bondians/led-thing/hardware/power-board/power-board.xlsx

 |  |  |  |  |  |  |  | Board Qty: | 5
 |  |  |  |  |  |  |  | Total Cost: | $266.84 |  |  |  | $273.83 |  |  |  |  |  | $179.22
 |  |  |  |  |  |  |  | Unit Cost: | $53.37
Global Part Info |  |  |  |  |  |  |  |  |  | Digi-Key |  |  |  |  |  | Mouser
Refs | Value | Desc | Note | Footprint | Manf | Manf# | Qty | Unit$ | Ext$ | Avail | Purch | Unit$ | Ext$ | Cat# | Doc | Avail | Purch | Unit$ | Ext$ | Cat# | Doc
J1001 | PA[5..7] |  |  | Pin_Headers:Pin_Header_Straight_1x03_Pitch2.54mm |  |  | 5 | $0.00 | $0.00
R303 | 105k |  |  | Resistors_SMD:R_0805 | Yageo | RC0805FR-07105KL | 5 | $0.10 | $0.50 | 150558 |  | $0.10 | $0.50 | 311-105KCRCT-ND | Link (http://www.digikey.com/product-detail/en/yageo/RC0805FR-07105KL/311-105KCRCT-ND/730495) | 15239 |  | $0.10 | $0.50 | 603-RC0805FR-07105KL | Link (http://www.mouser.com/ProductDetail/Yageo/RC0805FR-07105KL/?qs=sGAEpiMZZMu61qfTUdNhG92fxgWN7axftU0W8jCwEoE%3d)
E301 | SPARK_GAP |  |  | project:Spark_Gap_8mil |  |  | 5 | $0.00 | $0.00
U401 | TLV521 |  |  | TO_SOT_Packages_SMD:SOT-353_SC-70-5 | Texas Instruments | TLV521DCKR | 5 | $0.18 | $0.92 |  |  | $0.18 | $0.92 | TLV521DCKR-ND | Link (http://www.digikey.com/scripts/DkSearch/dksus.dll?WT.z_header=search_go&lang=en&keywords=TLV521DCKR) | 56085 |  | $0.51 | $2.56 | 595-TLV521DCKR | Link (http://www.mouser.com/ProductDetail/Texas-Instruments/TLV521DCKR/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)
U1101 | TPD2E001IDRLRQ1 |  |  | TO_SOT_Packages_SMD:SOT-553 | Texas Instruments | TPD2E001IDRLRQ1 | 5 | $0.57 | $2.86 | 4979 |  | $0.58 | $2.90 | 296-29985-1-ND | Link (http://www.digikey.com/product-detail/en/texas-instruments/TPD2E001IDRLRQ1/296-29985-1-ND/2791193) | 9891 |  | $0.57 | $2.86 | 595-TPD2E001IDRLRQ1 | Link (http://www.mouser.com/Search/Refine.aspx?Keyword=TPD2E001IDRLRQ1)
D301 | 5A |  |  | Diodes_SMD:D_SMC_Standard | SMC Diode Solutions | SK520TR | 5 | $0.42 | $2.10 | 1160 |  | $0.42 | $2.10 | 1655-1603-1-ND | Link (http://www.digikey.com/product-detail/en/smc-diode-solutions/SK520TR/1655-1603-1-ND/6023048)
R401 | 10M |  | 1% | Resistors_SMD:R_0805 | Yageo | RC0805FR-0710ML | 5 | $0.10 | $0.50 | 309331 |  | $0.10 | $0.50 | 311-10.0MCRCT-ND | Link (http://www.digikey.com/product-detail/en/yageo/RC0805FR-0710ML/311-10.0MCRCT-ND/730483)
C501 | 10n |  | DNS | Capacitors_SMD:C_0603 | Murata Electronics | GRM188R71H103JA01D | 5 | $0.10 | $0.50 | 86478 |  | $0.10 | $0.50 | 490-9734-1-ND | Link (http://www.digikey.com/product-detail/en/murata-electronics-north-america/GRM188R71H103JA01D/490-9734-1-ND/4934907)
J1002 | PB[0..3] |  |  | Pin_Headers:Pin_Header_Straight_1x04_Pitch2.54mm |  |  | 5 | $0.00 | $0.00
J801 | CONN_02X05 |  |  | Connectors:IDC_Header_Straight_10pins | 3M Electronic Solutions Division | N2510-6002RB | 5 | $1.48 | $7.40 | 13958 |  | $1.84 | $9.20 | MHC10K-ND | Link (http://www.digikey.com/product-detail/en/3m/N2510-6002-RB/MHC10K-ND/755176) | 13226 |  | $1.48 | $7.40 | 517-N2510-6002RB | Link (http://www.mouser.com/ProductDetail/3M-Electronic-Solutions-Division/N2510-6002RB/)
U701 | Main Reg |  |  | Housings_SSOP:MSOP-8_3x3mm_Pitch0.65mm | Microchip Technology | AT30TS74-XM8M-B | 5 | $0.56 | $2.80 | 2539 |  | $0.56 | $2.80 | 1611-AT30TS74-XM8M-B-ND | Link (http://www.digikey.com/product-detail/en/microchip-technology/AT30TS74-XM8M-B/1611-AT30TS74-XM8M-B-ND/6829296)
J301 | CONN_01X02 |  |  | Connectors_Terminal_Blocks:TerminalBlock_Pheonix_PT-3.5mm_2pol | Phoenix Contact | 1984617 | 5 | $0.43 | $2.15 | 15649 |  | $0.43 | $2.15 | 277-1721-ND | Link (http://www.digikey.com/scripts/DkSearch/dksus.dll?WT.z_header=search_go&lang=en&keywords=1984617) | 7214 |  | $0.43 | $2.16 | 651-1984617 | Link (http://www.mouser.com/Search/Refine.aspx?Keyword=1984617)
C212 | 0.47u |  |  | Capacitors_SMD:C_0603 | Murata Electronics | GCM188R71C474KA55D | 5 | $0.13 | $0.65 | 141742 |  | $0.13 | $0.65 | 490-4775-1-ND | Link (http://www.digikey.com/product-detail/en/murata-electronics-north-america/GCM188R71C474KA55D/490-4775-1-ND/1641694)
R304 | 4.02k |  |  | Resistors_SMD:R_0805 | Yageo | RC0805FR-074K02L | 5 | $0.10 | $0.50 | 174315 |  | $0.10 | $0.50 | 311-4.02KCRCT-ND | Link (http://www.digikey.com/product-detail/en/yageo/RC0805FR-074K02L/311-4.02KCRCT-ND/730854) | 40681 |  | $0.10 | $0.50 | 603-RC0805FR-074K02L | Link (http://www.mouser.com/Search/Refine.aspx?Keyword=RC0805FR-074K02L%20Yageo)
D302 | 36V |  |  | Diodes_SMD:D_SMA_Standard | Wurth Electronics Inc. | 824501361 | 5 | $0.27 | $1.35 | 911 |  | $0.27 | $1.35 | 732-9957-1-ND | Link (http://www.digikey.com/product-detail/en/wurth-electronics-inc/824501361/732-9957-1-ND/5871110)
R901 | 0 |  | DNS | Resistors_SMD:R_0603 | Yageo | RC0603JR-070RL | 5 | $0.10 | $0.50 | 11252691 |  | $0.10 | $0.50 | 311-0.0GRCT-ND | Link (http://www.digikey.com/product-detail/en/yageo/RC0603JR-070RL/311-0.0GRCT-ND/729622) | 1127807 |  | $0.10 | $0.50 | 603-RC0603JR-070RL | Link (http://www.mouser.com/Search/Refine.aspx?Keyword=RC0603JR-070RL%20Yageo)
J901-J905 | CONN_01X04 |  |  | Connectors_Terminal_Blocks:TerminalBlock_Pheonix_PT-3.5mm_4pol | Phoenix Contact | 1984633 | 25 | $0.79 | $19.82 | 3312 |  | $0.82 | $20.42 | 277-1860-ND | Link (http://www.digikey.com/scripts/DkSearch/dksus.dll?WT.z_header=search_go&lang=en&keywords=1984633) | 4060 |  | $0.79 | $19.82 | 651-1984633 | Link (http://www.mouser.com/Search/Refine.aspx?Keyword=1984633)
D201 | 5.1V |  | DNS | Diodes_SMD:D_SOD-123 |  |  | 5 | $0.00 | $0.00
J1101 | USB_OTG |  |  | Connectors:USB_Micro-B_10103594-0001LF | Amphenol FCI | 10103594-0001LF | 5 | $0.67 | $3.37 | 91142 |  | $0.73 | $3.65 | 609-4050-1-ND | Link (http://www.digikey.com/product-detail/en/amphenol-fci/10103594-0001LF/609-4050-1-ND/2350357) | 59077 |  | $0.67 | $3.37 | 649-10103594-0001LF | Link (http://www.mouser.com/Search/Refine.aspx?Keyword=10103594-0001LF)
R205 | 2.15k |  |  | Resistors_SMD:R_0805 | Yageo | RC0805FR-072K15L | 5 | $0.10 | $0.50 | 73222 |  | $0.10 | $0.50 | 311-2.15KCRCT-ND | Link (http://www.digikey.com/product-detail/en/yageo/RC0805FR-072K15L/311-2.15KCRCT-ND/730620)
FB1101 | Filter |  |  | Resistors_SMD:R_0805 | TDK | MPZ2012S102AT000 | 5 | $0.11 | $0.55 | 268519 |  | $0.11 | $0.55 | 445-5223-1-ND | Link (http://www.digikey.com/product-detail/en/tdk-corporation/MPZ2012S102AT000/445-5223-1-ND/2117957)
R503,R505 | R |  | DNS | Resistors_SMD:R_0805 |  |  | 10 | $0.00 | $0.00
C802,C804 | 10u |  | DNS | Capacitors_SMD:C_0805 | Samsung | CL21A106KOQNNNG | 10 | $0.14 | $1.36 | 270027 |  | $0.14 | $1.36 | 1276-1096-1-ND | Link (http://www.digikey.com/product-detail/en/samsung-electro-mechanics-america-inc/CL21A106KOQNNNE/1276-1096-1-ND/3889182)
C208-C210,C213 | 330u |  | 6.3V, 0.025 ohm | Capacitors_Tantalum_SMD:Tantalum_Case-V_EIA-7343-20_Hand | AVX Corporation | TCJD337M006R0025 | 20 | $1.15 | $23.00 | 697 |  | $1.23 | $24.64 | 478-9446-1-ND | Link (http://www.digikey.com/product-detail/en/avx-corporation/TCJD337M006R0025/478-9446-1-ND/5001658) | 1000 |  | $1.15 | $23.00 | 581-TCJD337M006R0025 | Link (http://www.mouser.com/Search/Refine.aspx?Keyword=TCJD337M006R0025)
C503 | 4.7uF, 50V |  | X7R | Capacitors_SMD:C_0805 | Samsung | CL21A475KQFNNNG | 5 | $0.10 | $0.50 | 23488 |  | $0.10 | $0.50 | 1276-6465-1-ND | Link (http://www.digikey.com/product-detail/en/samsung-electro-mechanics-america-inc/CL21A475KQFNNNG/1276-6465-1-ND/5958093)
TP601 | RESET |  |  | Connectors:PINTST |  |  | 5 | $0.00 | $0.00
R601,R603,R608-R615 | 68 |  | DNS | Resistors_SMD:R_0603 | Yageo | RC0603JR-0768RL | 50 | $0.01 | $0.55 | 775136 |  | $0.01 | $0.55 | 311-68GRCT-ND | Link (http://www.digikey.com/product-detail/en/yageo/RC0603JR-0768RL/311-68GRCT-ND/729768)
U601 | ATXMEGA32A4U-AU |  |  | Housings_QFP:TQFP-44_10x10mm_Pitch0.8mm | Microchip Technology | ATXMEGA32A4U-AU | 5 | $2.99 | $14.95 | 1932 |  | $2.99 | $14.95 | ATXMEGA32A4U-AU-ND | Link (http://www.digikey.com/product-detail/en/microchip-technology/ATXMEGA32A4U-AU/ATXMEGA32A4U-AU-ND/3046479)
C403,C404,C504 | C |  | DNS | Capacitors_SMD:C_0603 |  |  | 15 | $0.00 | $0.00
R204 | 84.5k |  |  | Resistors_SMD:R_0805 | Yageo | RC0805FR-0784K5L | 5 | $0.10 | $0.50 | 21890 |  | $0.10 | $0.50 | 311-84.5KCRCT-ND | Link (http://www.digikey.com/product-detail/en/yageo/RC0805FR-0784K5L/311-84.5KCRCT-ND/731120) | 1941 |  | $0.10 | $0.50 | 603-RC0805FR-0784K5L | Link (http://www.mouser.com/ProductDetail/Yageo/RC0805FR-0784K5L/)
U901 | CD4504B |  |  | Housings_SOIC:SOIC-16_3.9x9.9mm_Pitch1.27mm | Texas Instruments | CD4504BM96 | 5 | $0.46 | $2.30 | 28371 |  | $0.46 | $2.30 | 296-14150-1-ND | Link (http://www.digikey.com/product-detail/en/texas-instruments/CD4504BM96/296-14150-1-ND/525967)
C302 | 1uF |  |  | Capacitors_SMD:C_0805 | Yageo | CC0805ZRY5V7BB105 | 5 | $0.10 | $0.50 | 367409 |  | $0.10 | $0.50 | 311-1457-1-ND | Link (http://www.digikey.com/product-detail/en/yageo/CC0805ZRY5V7BB105/311-1457-1-ND/2833763) | 31315 |  | $0.10 | $0.50 | 603-CC805ZRY5V7BB105 | Link (http://www.mouser.com/Search/Refine.aspx?Keyword=CC0805ZRY5V7BB105%20Yageo)
J601 | PDI |  |  | Connectors:Tag-Connect_TC2030-IDC-NL |  |  | 5 | $0.00 | $0.00
R302,R501,R604,R605 | 100k |  |  | Resistors_SMD:R_0603 | Yageo | RC0603JR-07100KL | 20 | $0.01 | $0.22 | 4007343 |  | $0.01 | $0.22 | 311-100KGRCT-ND | Link (http://www.digikey.com/product-detail/en/yageo/RC0603JR-07100KL/311-100KGRCT-ND/729645)
C205,C206 | 47n |  | X7R | Capacitors_SMD:C_0603 | Murata Electronics | GCM188R71H473KA55D | 10 | $0.06 | $0.58 | 2731033 |  | $0.10 | $1.05 | 490-4934-1-ND | Link (http://www.digikey.com/product-detail/en/murata-electronics-north-america/GCM188R71H473KA55D/490-4934-1-ND/1765253) | 327975 |  | $0.06 | $0.58 | 81-GCM188R71H473K55D | Link (http://www.mouser.com/Search/Refine.aspx?Keyword=GCM188R71H473KA55D)
F301 | 4.5A |  | OPT | Resistors_SMD:R_0603_HandSoldering | Littelfuse | 0603SFS450F/32-2 | 5 | $0.35 | $1.76 | 4000 |  | $0.78 | $3.92 | 0603SFS450F/32-2CT-ND | Link (http://www.digikey.com/product-detail/en/littelfuse-inc/0603SFS450F-32-2/0603SFS450F-32-2CT-ND/2037159) |  |  | $0.35 | $1.76 | 650-0603SFS450F/32-2 | Link (http://www.mouser.com/Search/Refine.aspx?Keyword=0603SFS450F%2F32-2)
U201 | LMZ23610 |  |  | project:TO-PMOD-11 | Texas Instruments | LMZ23610TZE/NOPB | 5 | $22.57 | $112.86 | 945 |  | $22.57 | $112.86 | 296-40334-1-ND | Link (http://www.digikey.com/product-detail/en/texas-instruments/LMZ23610TZE-NOPB/296-40334-1-ND/5178211) |  |  | $22.64 | $113.20 | 926-LMZ23610TZE/NOPB | Link (http://www.mouser.com/Search/Refine.aspx?Keyword=LMZ23610TZE%2FNOPB)
C601,C606 | 10u |  |  | Capacitors_SMD:C_0805 | Samsung | CL21A106KOQNNNG | 10 | $0.14 | $1.36 | 270027 |  | $0.14 | $1.36 | 1276-1096-1-ND | Link (http://www.digikey.com/product-detail/en/samsung-electro-mechanics-america-inc/CL21A106KOQNNNE/1276-1096-1-ND/3889182)
Y601 | 16MHz |  | DNS | Crystals:Crystal_SMD_Abracon_ABM3-2pin_5.0x3.2mm_HandSoldering | Abracon | ABM3-16.000MHZ-B2-T | 5 | $0.69 | $3.45 | 5261 |  | $0.69 | $3.45 | 535-9103-1-ND | Link (http://www.digikey.com/product-detail/en/abracon-llc/ABM3-16.000MHZ-B2-T/535-9103-1-ND/675620)
C904,C906,C908,C910,C912 | 10u |  |  | Capacitors_SMD:C_0805 | Samsung | CL21A106KOQNNNG | 25 | $0.14 | $3.40 | 270027 |  | $0.14 | $3.40 | 1276-1096-1-ND | Link (http://www.digikey.com/product-detail/en/samsung-electro-mechanics-america-inc/CL21A106KOQNNNE/1276-1096-1-ND/3889182)
C505 | C |  | DNS | Capacitors_SMD:C_0805 |  |  | 5 | $0.00 | $0.00
J1103 | CSHARE_OUT |  |  | Pin_Headers:Pin_Header_Straight_2x04_Pitch2.54mm |  |  | 5 | $0.00 | $0.00
J906 | PC[0..1] |  |  | Pin_Headers:Pin_Header_Straight_1x02_Pitch2.54mm |  |  | 5 | $0.00 | $0.00
R606,R607 | 2.2k |  |  | Resistors_SMD:R_0603 | Yageo | RC0603JR-072K2L | 10 | $0.01 | $0.11 | 980562 |  | $0.01 | $0.11 | 311-2.2KGRCT-ND | Link (http://www.digikey.com/product-detail/en/yageo/RC0603JR-072K2L/311-2.2KGRCT-ND/729676)
C201,C1102 | 4.7n |  |  | Capacitors_SMD:C_0603 | Samsung | CL10B472KB8NNNC | 10 | $0.01 | $0.11 | 692434 |  | $0.01 | $0.11 | 1276-1098-1-ND | Link (http://www.digikey.com/product-detail/en/samsung-electro-mechanics-america-inc/CL10B472KB8NNNC/1276-1098-1-ND/3889184)
Q301 | Q_NMOS_SSSGD |  |  | TO_SOT_Packages_SMD:SOT-669_LFPAK_ThermalVias-1 | Nexperia USA Inc. | PSMN019-100YLX | 5 | $0.96 | $4.80 | 1663 |  | $0.96 | $4.80 | 1727-2592-1-ND | Link (http://www.digikey.com/product-detail/en/nexperia-usa-inc/PSMN019-100YLX/1727-2592-1-ND/6167603)
R1101 | 1M |  |  | Resistors_SMD:R_0603 | Yageo | RC0603JR-071ML | 5 | $0.10 | $0.50 | 1590654 |  | $0.10 | $0.50 | 311-1.0MGRCT-ND | Link (http://www.digikey.com/product-detail/en/yageo/RC0603JR-071ML/311-1.0MGRCT-ND/729625)
C202-C204 | 10uF |  | 50V, Low ESL | Capacitors_SMD:C_1210 | TDK Corporation | C3225X7S1H106M250AB | 15 | $0.57 | $8.58 | 209847 |  | $0.57 | $8.58 | 445-4537-1-ND | Link (http://www.digikey.com/product-detail/en/tdk-corporation/C3225X7S1H106M250AB/445-4537-1-ND/2042333)
R203 | 0 |  |  | Resistors_SMD:R_0805 | Yageo | RC0805JR-070RL | 5 | $0.10 | $0.50 | 7370644 |  | $0.10 | $0.50 | 311-0.0ARCT-ND | Link (http://www.digikey.com/product-detail/en/yageo/RC0805JR-070RL/311-0.0ARCT-ND/731163)
C301 | 330u, 50V |  |  | Capacitors_THT:CP_Radial_D10.0mm_P5.00mm | Panasonic Electronic Components | ECA-1HM331 | 5 | $0.45 | $2.25 | 47049 |  | $0.45 | $2.25 | P5184-ND | Link (http://www.digikey.com/product-detail/en/panasonic-electronic-components/ECA-1HM331/P5184-ND/245043)
H101-H104 | M3 |  |  | Mounting_Holes:MountingHole_3.2mm_M3_Pad |  |  | 20 | $0.00 | $0.00
C211,C401,C602-C605,C701,C901,C902,C1101 | 0.1u |  |  | Capacitors_SMD:C_0603 | Murata Electronics | GRM188R71H104KA93D | 50 | $0.08 | $4.20 | 21159330 |  | $0.08 | $4.20 | 490-1519-1-ND | Link (http://www.digikey.com/product-detail/en/murata-electronics-north-america/GRM188R71H104KA93D/490-1519-1-ND/587854)
R403,R704-R706,R902 | 0 |  |  | Resistors_SMD:R_0603 | Yageo | RC0603JR-070RL | 25 | $0.01 | $0.18 | 11252691 |  | $0.01 | $0.18 | 311-0.0GRCT-ND | Link (http://www.digikey.com/product-detail/en/yageo/RC0603JR-070RL/311-0.0GRCT-ND/729622)
R622 | 10k |  |  | Resistors_SMD:R_0603 | Vishay | CRCW060310K0FKEA | 5 | $0.10 | $0.50 |  |  | $0.10 | $0.50 | 541-10.0KHCT-ND | Link (http://www.digikey.com/product-detail/en/vishay-dale/CRCW060310K0FKEA/541-10.0KHCT-ND/1179924)
U501 | 3.3v |  |  | Housings_SSOP:MSOP-8-1EP_3x3mm_Pitch0.65mm | Texas Instruments | TPS7A6633QDGNRQ1 | 5 | $1.77 | $8.85 |  |  | $1.77 | $8.85 | 296-39504-1-ND | Link (http://www.digikey.com/product-detail/en/texas-instruments/TPS7A6633QDGNRQ1/296-39504-1-ND/5143451)
R101 | 0 |  | DNS | Resistors_SMD:R_0805 | Yageo | RC0805JR-070RL | 5 | $0.10 | $0.50 | 7370644 |  | $0.10 | $0.50 | 311-0.0ARCT-ND | Link (http://www.digikey.com/product-detail/en/yageo/RC0805JR-070RL/311-0.0ARCT-ND/731163)
R402 | 316k |  | 1% | Resistors_SMD:R_0805 | Yageo | RC0805FR-07316KL | 5 | $0.10 | $0.50 | 38221 |  | $0.10 | $0.50 | 311-316KCRCT-ND | Link (http://www.digikey.com/product-detail/en/yageo/RC0805FR-07316KL/311-316KCRCT-ND/730804)
C607,C608 | 26p |  |  | Capacitors_SMD:C_0805 | Johanson Dielectrics Inc. | 500R15N270KV4T | 10 | $0.05 | $0.53 | 38486 |  | $0.05 | $0.53 | 709-1173-1-ND | Link (http://www.digikey.com/product-detail/en/johanson-dielectrics-inc/500R15N270KV4T/709-1173-1-ND/1859505)
FB601 | FB |  |  | Resistors_SMD:R_0805 | TDK | MPZ2012S102AT000 | 5 | $0.11 | $0.55 | 268519 |  | $0.11 | $0.55 | 445-5223-1-ND | Link (http://www.digikey.com/product-detail/en/tdk-corporation/MPZ2012S102AT000/445-5223-1-ND/2117957)
R301 | 10m |  |  | Resistors_SMD:R_1206 | Samsung | RU3216FR010CS | 5 | $0.39 | $1.95 |  |  | $0.39 | $1.95 | 1276-6160-1-ND | Link (http://www.digikey.com/product-detail/en/samsung-electro-mechanics-america-inc/RU3216FR010CS/1276-6160-1-ND/3969132)
C801,C803 | 1u |  | DNS | Capacitors_SMD:C_0603 | Samsung | CL10B105KO8NNNC | 10 | $0.04 | $0.45 | 1503299 |  | $0.04 | $0.45 | 1276-1019-1-ND | Link (http://www.digikey.com/product-detail/en/samsung-electro-mechanics-america-inc/CL10B105KO8NNNC/1276-1019-1-ND/3889105)
SW601 | RESET |  |  | Buttons_Switches_SMD:SW_SPST_EVPBF | Panasonic Electronic Components | EVP-BFAC1A000 | 5 | $0.30 | $1.50 | 5702 |  | $0.30 | $1.50 | P19749CT-ND | Link (http://www.digikey.com/product-detail/en/panasonic-electronic-components/EVP-BFAC1A000/P19749CT-ND/6125116)
J1102 | CSHARE_IN |  |  | Pin_Headers:Pin_Header_Straight_2x04_Pitch2.54mm |  |  | 5 | $0.00 | $0.00
C402 | 1u |  |  | Capacitors_SMD:C_0603 | Samsung | CL10B105KO8NNNC | 5 | $0.10 | $0.50 | 1503299 |  | $0.10 | $0.50 | 1276-1019-1-ND | Link (http://www.digikey.com/product-detail/en/samsung-electro-mechanics-america-inc/CL10B105KO8NNNC/1276-1019-1-ND/3889105)
U301 | RT1720 |  |  | Housings_SSOP:MSOP-10_3x3mm_Pitch0.5mm | Richtek USA Inc. | RT1720GF | 5 | $1.74 | $8.70 |  |  | $1.74 | $8.70 | 1028-1445-1-ND | Link (http://www.digikey.com/product-detail/en/richtek-usa-inc/RT1720GF/1028-1445-1-ND/6002785)
D501 | MMBD1204 |  |  | TO_SOT_Packages_SMD:SOT-23 | Fairchild/ON Semiconductor | MMBD1204 | 5 | $0.29 | $1.45 | 31098 |  | $0.29 | $1.45 | MMBD1204CT-ND | Link (http://www.digikey.com/product-detail/en/fairchild-on-semiconductor/MMBD1204/MMBD1204CT-ND/458963)
R602,R616-R621 | 68 |  |  | Resistors_SMD:R_0603 | Yageo | RC0603JR-0768RL | 35 | $0.01 | $0.38 | 775136 |  | $0.01 | $0.38 | 311-68GRCT-ND | Link (http://www.digikey.com/product-detail/en/yageo/RC0603JR-0768RL/311-68GRCT-ND/729768)
R201 | 1.91M |  |  | Resistors_SMD:R_0805 | Yageo | RC0805FR-071M91L | 5 | $0.10 | $0.50 | 1284 |  | $0.10 | $0.50 | 311-1.91MCRCT-ND | Link (http://www.digikey.com/product-detail/en/yageo/RC0805FR-071M91L/311-1.91MCRCT-ND/730477)
C207 | 47u |  | X7R | Capacitors_SMD:C_0805 | Taiyo Yuden | JMK212BBJ476MG-T | 5 | $0.38 | $1.90 | 396 |  | $0.38 | $1.90 | 587-4280-1-ND | Link (http://www.digikey.com/product-detail/en/taiyo-yuden/JMK212BBJ476MG-T/587-4280-1-ND/5344315)
C502 | 47u |  |  | Capacitors_SMD:C_0805 | Taiyo Yuden | JMK212BBJ476MG-T | 5 | $0.38 | $1.90 | 396 |  | $0.38 | $1.90 | 587-4280-1-ND | Link (http://www.digikey.com/product-detail/en/taiyo-yuden/JMK212BBJ476MG-T/587-4280-1-ND/5344315)
R502,R504,R701-R703 | R |  | DNS | Resistors_SMD:R_0603 | Yageo | RC0603JR-070RL | 25 | $0.01 | $0.18 | 11252691 |  | $0.01 | $0.18 | 311-0.0GRCT-ND | Link (http://www.digikey.com/product-detail/en/yageo/RC0603JR-070RL/311-0.0GRCT-ND/729622)
R202 | 11.3k |  |  | Resistors_SMD:R_0805 | Yageo | RC0805FR-0711K3L | 5 | $0.10 | $0.50 | 165446 |  | $0.10 | $0.50 | 311-11.3KCRCT-ND | Link (http://www.digikey.com/product-detail/en/yageo/RC0805FR-0711K3L/311-11.3KCRCT-ND/730501)
