bondians/led-thing/(threads)

Thread 1 (2017-09-09):

Toolchain?

n9xmj, 2017-09-09:
What toolchain (EDA) package was used to create the schematics, layout, etc?

mokus0, 2017-09-12:
KiCAD 4.0.x

Closed 2017-09-12.
