bondians/led-thing/hardware/power-board/schematic/power-board.pdf

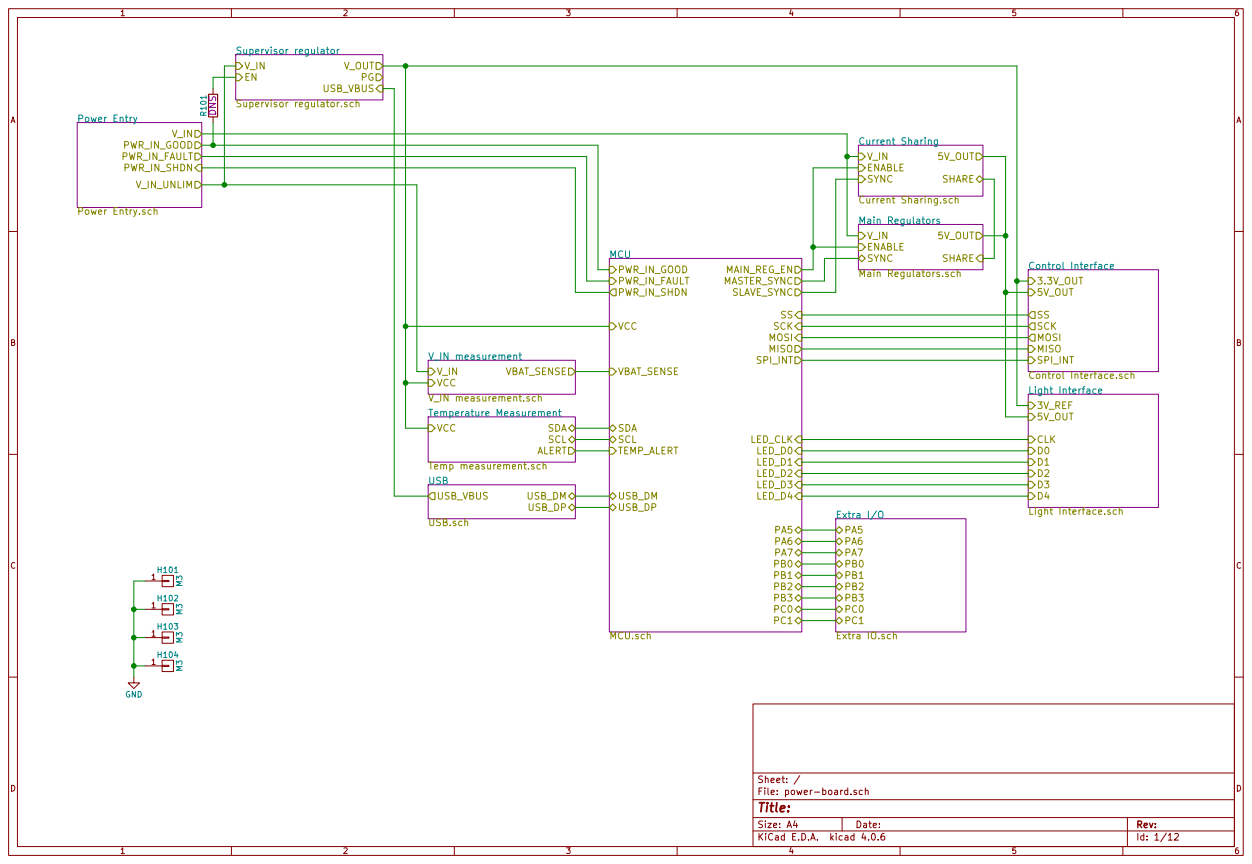
[picture p2: page 1]

File: power-board.sch Sheet: /
Id: 1/12 Title:

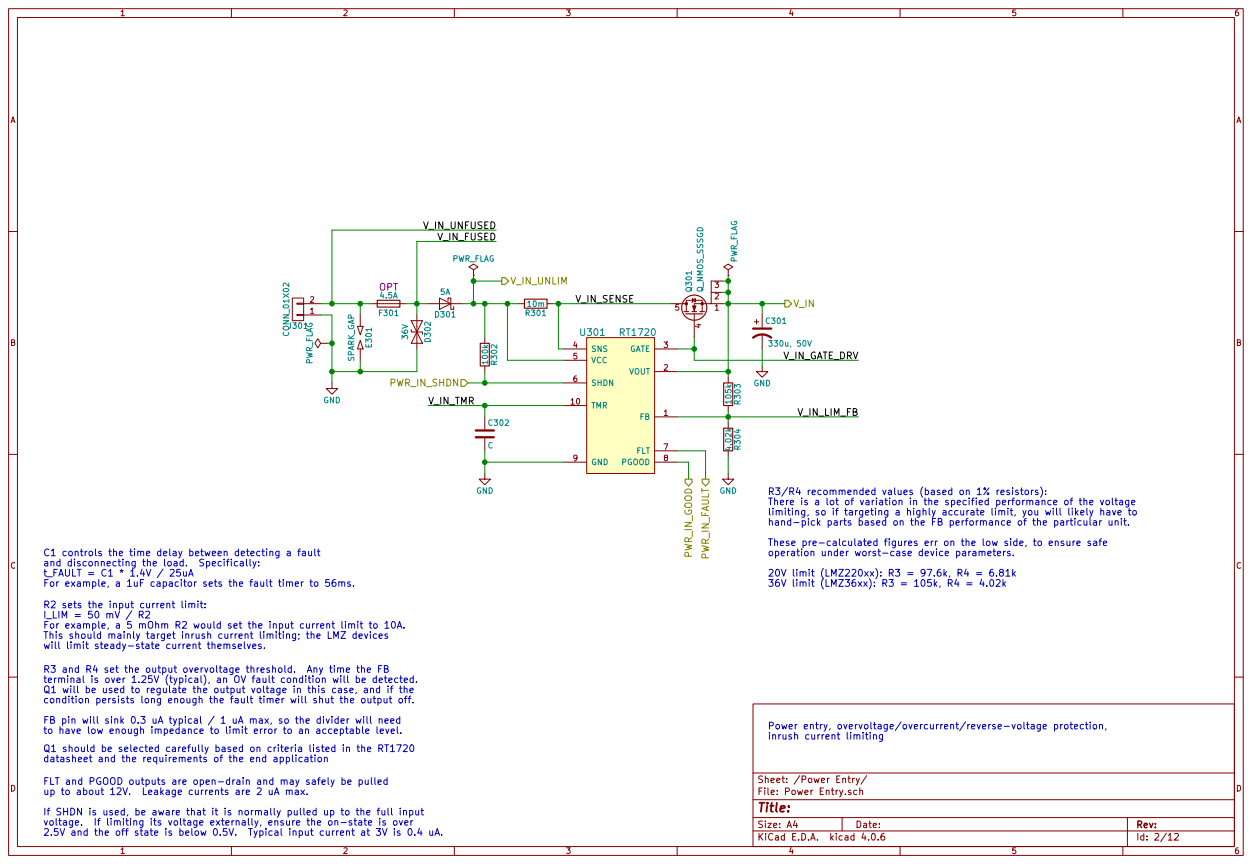
[picture p3: page 2]

R3/R4 recommended values (based on 1% resistors):
There is a lot of variation in the specified performance of the voltage
limiting, so if targeting a highly accurate limit, you will likely have to
hand-pick parts based on the FB performance of the particular unit.
These pre-calculated figures err on the low side, to ensure safe
operation under worst-case device parameters.
20V limit (LMZ220xx): R3 = 97.6k, R4 = 6.81k

C1 controls the time delay between detecting a fault
and disconnecting the load. Specifically:
t_FAULT = C1 * 1.4V / 25uA
For example, a 1uF capacitor sets the fault timer to 56ms.

R2 sets the input current limit:
I_LIM = 50 mV / R2
For example, a 5 mOhm R2 would set the input current limit to 10A.
This should mainly target inrush current limiting; the LMZ devices
will limit steady-state current themselves.

R3 and R4 set the output overvoltage threshold. Any time the FB
terminal is over 1.25V (typical), an OV fault condition will be detected.
Q1 will be used to regulate the output voltage in this case, and if the
condition persists long enough the fault timer will shut the output off.
FB pin will sink 0.3 uA typical / 1 uA max, so the divider will need
to have low enough impedance to limit error to an acceptable level.
Q1 should be selected carefully based on criteria listed in the RT1720
datasheet and the requirements of the end application

Power entry, overvoltage/overcurrent/reverse-voltage protection,
inrush current limiting

Sheet: /Power Entry/
File: Power Entry.sch
Id: 2/12 Title:

FLT and PGOOD outputs are open-drain and may safely be pulled
up to about 12V. Leakage currents are 2 uA max.
If SHDN is used, be aware that it is normally pulled up to the full input
voltage. If limiting its voltage externally, ensure the on-state is over
2.5V and the off state is below 0.5V. Typical input current at 3V is 0.4 uA.

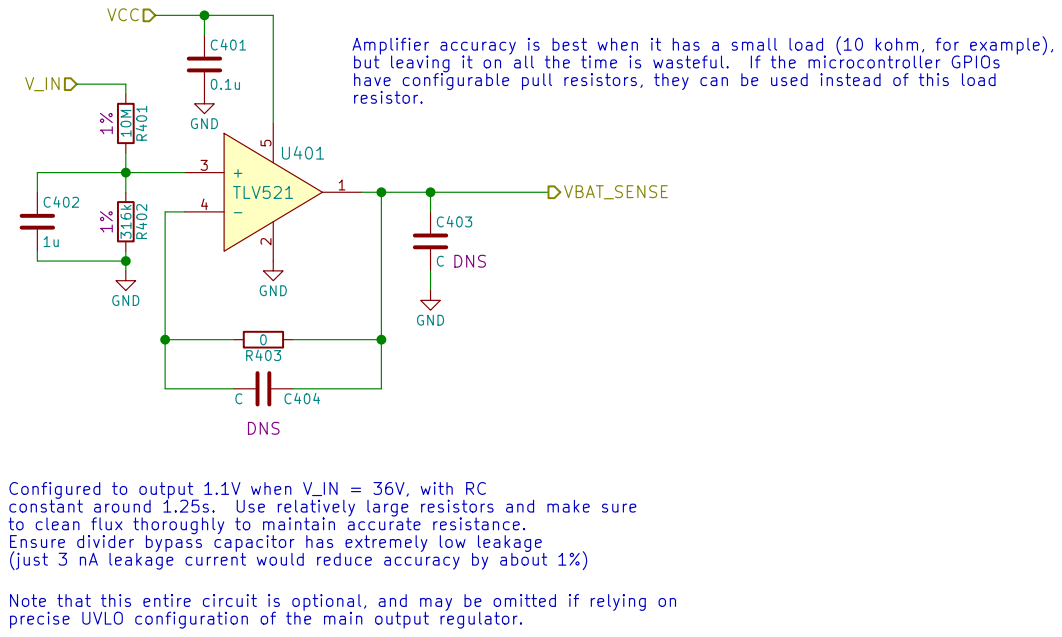
[picture p4: page 3]

Amplifier accuracy is best when it has a small load (10 kohm, for example),
but leaving it on all the time is wasteful. If the microcontroller GPIOs
have configurable pull resistors, they can be used instead of this load

resistor. Note that this entire circuit is optional, and may be omitted if relying on

GND GND Configured to output 1.1V when V_IN = 36V, with RC

constant around 1.25s. Use relatively large resistors and make sure
to clean flux thoroughly to maintain accurate resistance.
Ensure divider bypass capacitor has extremely low leakage

precise UVLO configuration of the main output regulator.

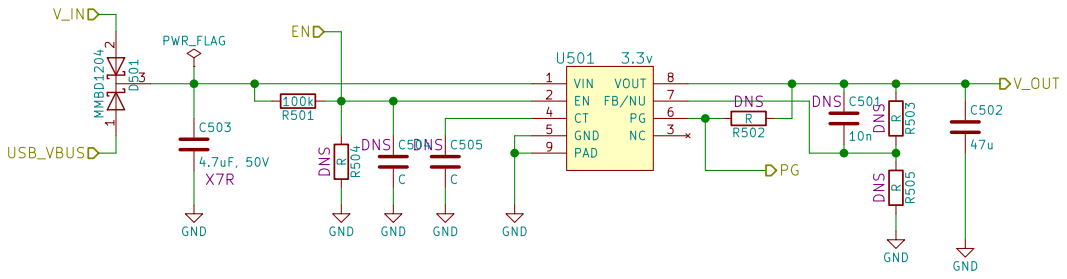
[picture p5: page 4]

Sheet: /Supervisor regulator/
File: Supervisor regulator.sch
Id: 4/12 Title:

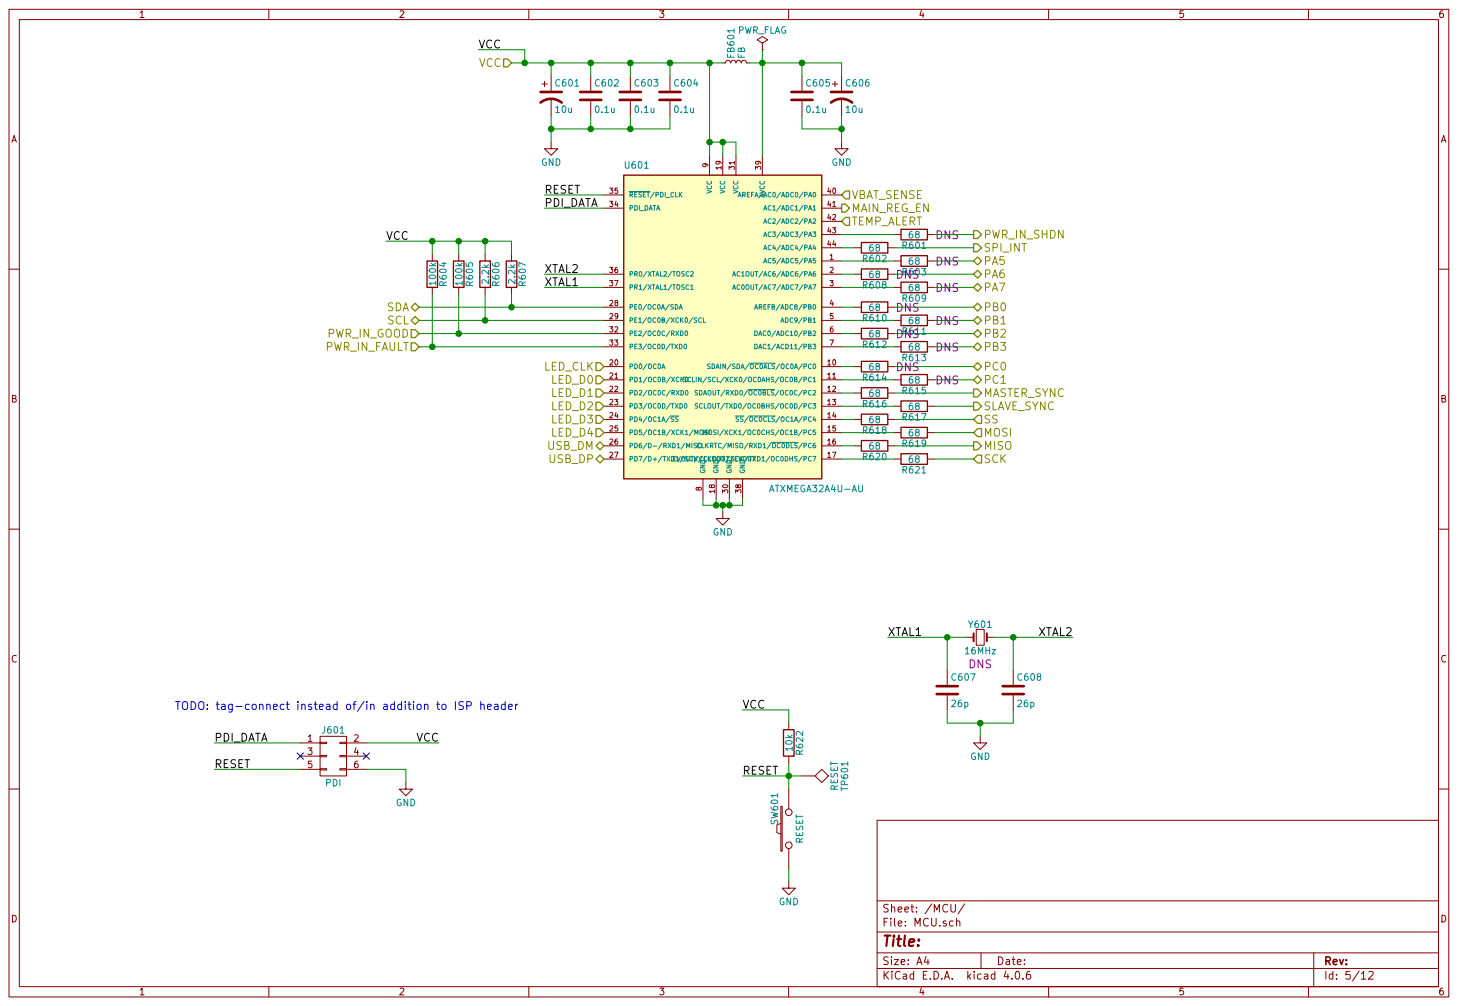
[picture p6: page 5]

9 SDAIN/SDA/OC0ALS/OC0A/PC0 10 PD0/OC0A 20 GND 30 AREFA/AC0/ADC0/PA0 40 SCLIN/SCL/XCK0/OC0AHS/OC0B/PC1 11 PD1/OC0B/XCK0 21 VCC 31 AC1/ADC1/PA1 41 SDAOUT/RXD0/OC0BLS/OC0C/PC2 12 PD2/OC0C/RXD0 22 PE2/OC0C/RXD0 32 AC2/ADC2/PA2 42 SCLOUT/TXD0/OC0BHS/OC0D/PC3 13 PD3/OC0D/TXD0 23 PE3/OC0D/TXD0 33 AC3/ADC3/PA3 43 SS/OC0CLS/OC1A/PC4 14 PD4/OC1A/SS 24 PDI_DATA 34 AC4/ADC4/PA4 44 MOSI/XCK1/OC0CHS/OC1B/PC5 15 PD5/OC1B/XCK1/MOSI 25 RESET/PDI_CLK 35 CLKRTC/MISO/RXD1/OC0DLS/PC6 16 PD6/D-/RXD1/MISO 26 PR0/XTAL2/TOSC2 36 EVOUT/CLKOUT/SCK/TXD1/OC0DHS/PC7 17 PD7/D+/TXD1/SCK/CLKOUT/EVOUT 27 PR1/XTAL1/TOSC1 37 GND 18 PE0/OC0A/SDA 28 GND 38 VCC 19 PE1/OC0B/XCK0/SCL 29 AVCC U601 39 ATXMEGA32A4U-AU RESET

Id: 5/12 Title: File: MCU.sch Sheet: /MCU/

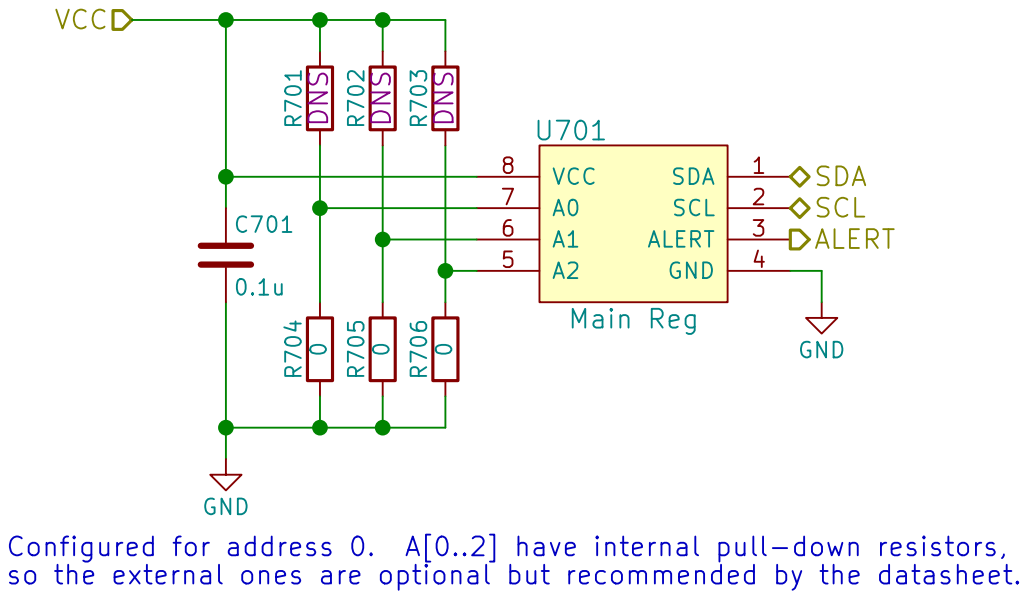
[picture p7: page 6]

SCL ALERT GND R706 0 R705 0 R704 0 R701 DNS

so the external ones are optional but recommended by the datasheet. C701

Configured for address 0. A[0..2] have internal pull-down resistors,

Sheet: /Temperature Measurement/
File: Temp measurement.sch
Id: 6/12 Title:

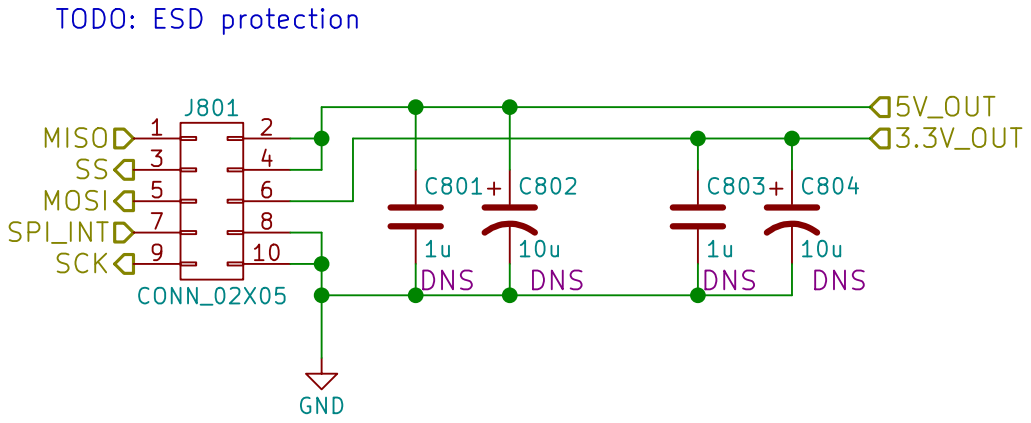
[picture p8: page 7]

Id: 7/12 Title: File: Control Interface.sch Sheet: /Control Interface/

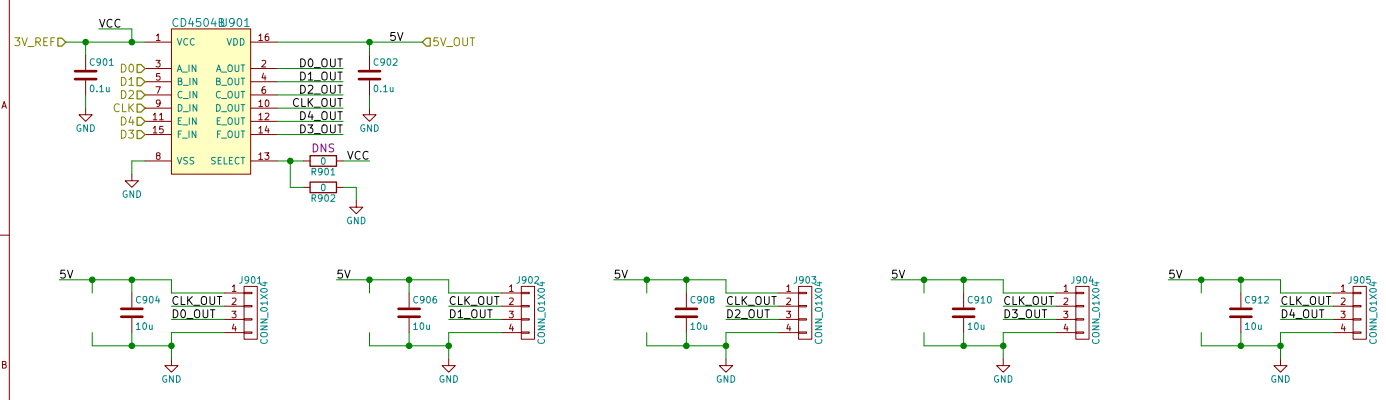
[picture p9: page 8]

Sheet: /Light Interface/
File: Light Interface.sch
Id: 8/12 Title:

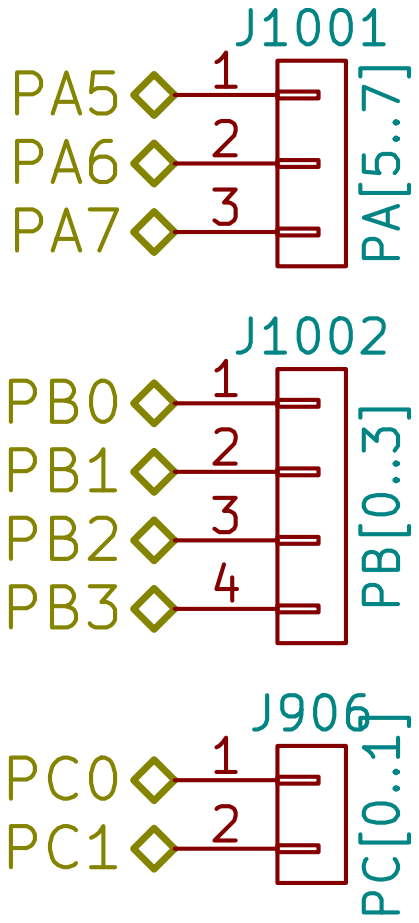
[picture p10: page 9]

Id: 9/12 Title: File: Extra IO.sch Sheet: /Extra I/O/

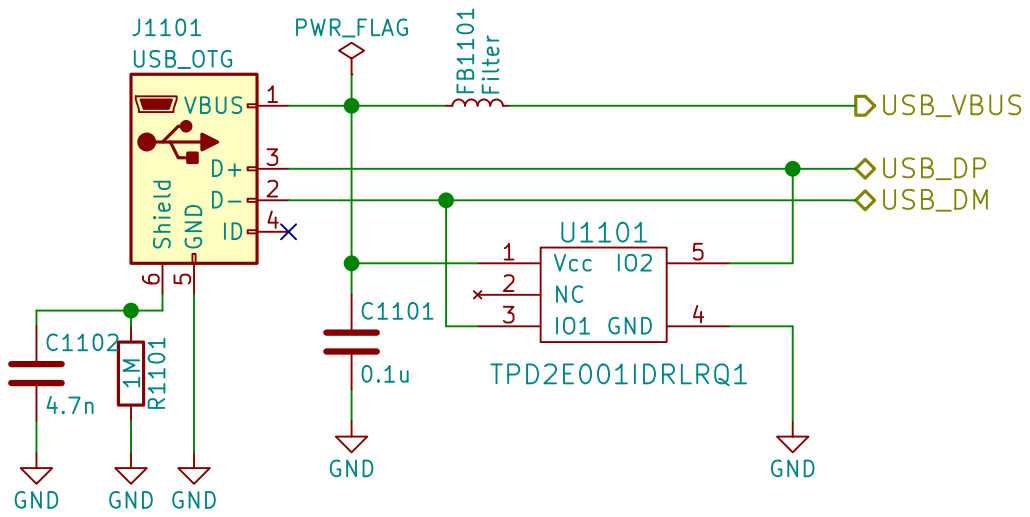
[picture p11: page 10]

USB_DP
Id: 10/12 Title: File: USB.sch Sheet: /USB/ USB_DM

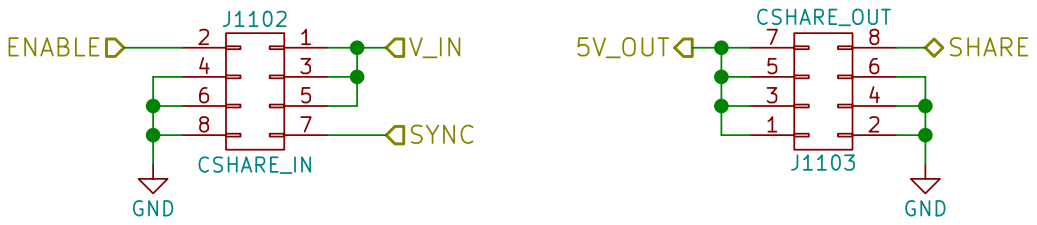
[picture p12: page 11]

Sheet: /Current Sharing/
File: Current Sharing.sch
Id: 11/12 Title:

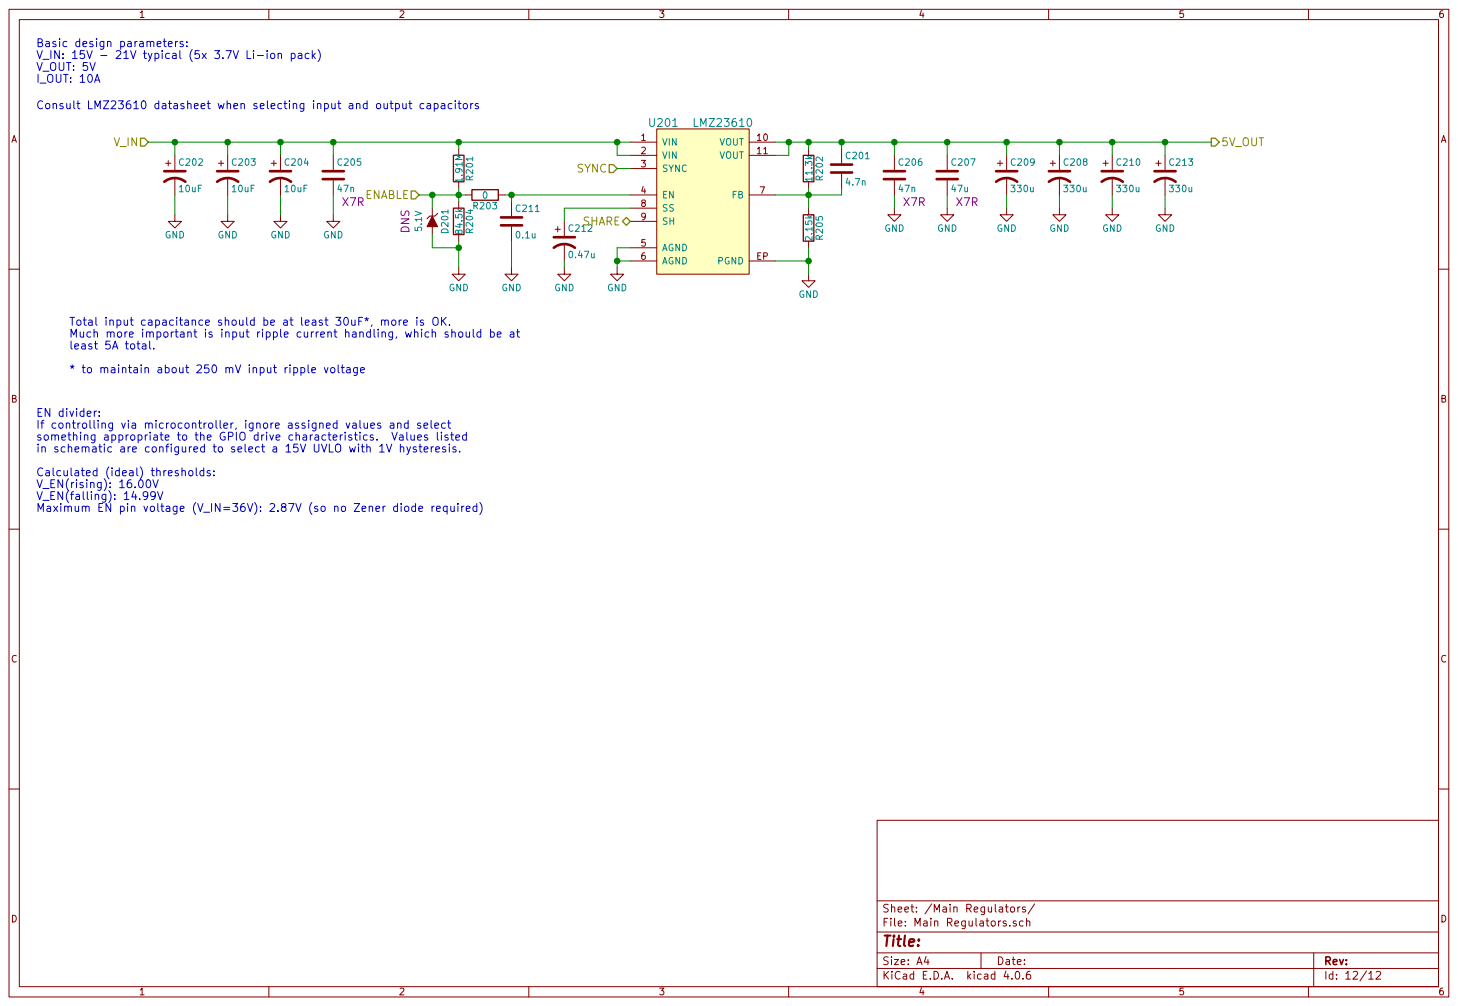
[picture p13: page 12]

V_IN: 15V - 21V typical (5x 3.7V Li-ion pack)
V_OUT: 5V

10uF GND Total input capacitance should be at least 30uF*, more is OK.

Much more important is input ripple current handling, which should be at

EN divider:
If controlling via microcontroller, ignore assigned values and select
something appropriate to the GPIO drive characteristics. Values listed
in schematic are configured to select a 15V UVLO with 1V hysteresis.
Calculated (ideal) thresholds:
V_EN(rising): 16.00V
V_EN(falling): 14.99V
Maximum EN pin voltage (V_IN=36V): 2.87V (so no Zener diode required)

Sheet: /Main Regulators/
File: Main Regulators.sch
Id: 12/12 Title:
