bondians/led-thing/(commit log)

2017-06-10 initial schematic design
    [Control Interface.sch, Light Interface.sch, MCU.sch, Main Regulators.sch, Power Entry.sch, Supervisor regulator.sch, Temp measurement.sch, V_IN measurement.sch]
2017-06-10 changed MCU to run at 3.3v
    [Control Interface.sch, Extra IO.sch, Light Interface.sch, MCU.sch, Main Regulators.sch, Power Entry.sch, Supervisor regulator.sch, Temp measurement.sch]
2017-06-10 switched to XMEGA A4U
    [Control Interface.sch, Extra IO.sch, Light Interface.sch, MCU.sch, Main Regulators.sch, Power Entry.sch, Supervisor regulator.sch, Temp measurement.sch]
2017-09-02 routed board
    [Control Interface.sch, Current Sharing.sch, Extra IO.sch, Light Interface.sch, MCU.sch, Main Regulators.sch, Power Entry.sch, Supervisor regulator.sch]
2017-09-02 cleaning up routing a bit, improving grounds, etc
    [power-board.kicad_pcb]
2017-09-02 added rendered schematic and kicost spreadsheet
    [power-board.kicad_pcb, power-board.xlsx]
2017-09-03 adding more part numbers
    [Light Interface.sch, Main Regulators.sch, Power Entry.sch, Supervisor regulator.sch, Temp measurement.sch, USB.sch, V_IN measurement.sch, power-board.sch]
2017-09-04 finished up parts ordering and generated gerbers
    [Light Interface.sch, Power Entry.sch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]
2017-09-08 re-plotted, i guess... didn't commit when i did it so i don't remember what's changed
    [power-board-B.Cu.gbl, power-board-Dwgs.User.gbr, power-board-Edge.Cuts.gm1, power-board-F.Cu.gtl, power-board-F.Mask.gts, power-board-F.Paste.gtp, power-board-F.SilkS.gto, power-board-NPTH.drl]
2018-02-10 setting up firmware project for power board
2018-02-10 adding generated gerbers and some notes about selection criteria for the input transistor
    [power-board-B.Cu.gbl, power-board-B.Mask.gbs, power-board-B.SilkS.gbo, power-board-Dwgs.User.gbr, power-board-Edge.Cuts.gm1, power-board-F.Cu.gtl, power-board-F.Mask.gts, power-board-F.Paste.gtp]
2018-02-12 added USB read/write based on 0-delimited frames
    also reduced usb endpoint buffer sizes to free up some space.
2018-02-16 moved hardware project into new hardware dir
    [Control Interface.sch, Current Sharing.sch, Extra IO.sch, Light Interface.sch, MCU.sch, Main Regulators.sch, Power Entry.sch, Supervisor regulator.sch]
2018-03-02 split the RX message handling out of frame handler
2018-03-02 moving frame and message logic out of usb
